marshy9/8086-Micro-Processor-Board-Project/(list of files, drawings)

Other design files:
PROJECT1.DSN
project1.opj
